maverstr/Thermography/README.md

# Thermography

Note : TFT_eSPI library should be moved into "Arduino/libraries" folder in root
