maverstr/Thermography/BillOfMatThermography.xlsx

Material | RS reference | URL | Price per component (£, ex. VAT) | Number of components
ESP32 | Digikey: ESP32-DEVKITC-32U-ND | https://www.digikey.co.uk/product-detail/en/espressif-systems/ESP32-DEVKITC-32U/ESP32-DEVKITC-32U-ND/9357002 | 8.23 | 1
MLX90640 | Digikey: MLX90640ESF-BAB-000-SP-ND | https://www.digikey.com/product-detail/en/melexis-technologies-nv/MLX90640ESF-BAB-000-SP/MLX90640ESF-BAB-000-SP-ND/8638466 | 37.27 | 1
ILI9341 TFT display | Digikey: 1528-1469-ND | https://www.digikey.com/products/en?mpart=1770&v=1528 | 24.09 | 1
Enclosure, ABS, 74x50x28mm | 314-5229 | https://uk.rs-online.com/web/p/potting-boxes/3145229/ | 1.592 | 1
BNC Connectors | 546-3995 | https://uk.rs-online.com/web/p/bnc-connectors/5463995/ | 2.49 | 1
Push-buttons SPST |  |  | 0.2 | 3
Toggle switches SPST | 419-855 | https://uk.rs-online.com/web/p/toggle-switches/0419855/ | 1.12 | 1
USB-C panel mount cable | Adafruit: 3258 | https://www.amazon.co.uk/Adafruit-Panel-Mount-Extension-Cable/dp/B0718XQPGB | 3.49 | 1
4-pin M12 automation cable | 724-2630 | https://uk.rs-online.com/web/p/sensor-switch-cables-connectors/7242630/ | 6.24 | 1
4-pin M12 straight connector | 124-7077 | https://uk.rs-online.com/web/p/industrial-automation-cable-assemblies/1247077/ | 4.38 | 1
Pin headers | 251-8351 | https://uk.rs-online.com/web/p/pcb-headers/2518351/ | 0.725 | 1
Total: |  |  | 90.227
PCB Ordering from JLCPCB |  |  | 1.61 | 1
PCB shipping to Leeds,UK | DHL internation shipping |  | 13 | 1
Some wires and Dupont wires
Electronics components
Resistors (ohms): | Number
16k | 1
160 | 1
10 | 1
Capacitors: (Farad)
10p | 1
10µ | 1
1µ | 1
100n | 1
Total including PCB and shipping: |  |  | 104.837
NOTE: Prices are mainly listed from RS components, VAT excluded. Prices taken 24/09/2019.
