maverstr/Thermography/Thermography_EAGLE_FILES_COPY/CAMOutputs/Assembly/wiring_thermography.txt

Partlist exported from C:/Users/Laurent/Documents/EAGLE/projects/ESP32 TEST/wiring_thermography.sch at 7/29/2019 9:21 AM

Qty Value         Device        Package        Parts                                                    Description               SPICEPREFIX
2                 C5/5          C5B5           C(RCANALOGOUT), C(RCSWITCH)                              CAPACITOR                            
1                 PINHD-1X1     1X01           ANALOGRCOUTPIN                                           PIN HEADER                           
1                 PINHD-1X10    1X10           LCDSPI                                                   PIN HEADER                           
1                 PINHD-1X5     1X05           MLX90640                                                 PIN HEADER                           
3                 R-EU_0207/7   0207/7         R(ANALOGOUT), R1(RCSWITCH), R2(RCSWITCH)                 RESISTOR, European symbol R          
1   100n          C5/5          C5B5           C2SUPPLYDECOUPLER                                        CAPACITOR                            
1   1µ            C5/5          C5B5           C1SUPPLYDECOUPLER                                        CAPACITOR                            
4   332-02        332-02        332-02         DRAWINGMODEPIN, REFFRAMEACTPIN, REFTAKEPIN, ROLLINGAVPIN 2 Pin - 2mm Dual Row                 
1   5v            PINHD-1X1     1X01           5VPIN                                                    PIN HEADER                           
1   ESP32DEVKITV1 ESP32DEVKITV1 ESP32-DEVKITV1 ESP32                                                                                         
3   gnd           PINHD-1X1     1X01           GNDPIN, GNDPIN2, GNDPIN3                                 PIN HEADER
