maverstr/Thermography/Thermography_EAGLE_FILES_COPY/wiring_thermography.brd

## EAGLE design Thermography_EAGLE_FILES_COPY/wiring_thermography.brd (2019-09-25)

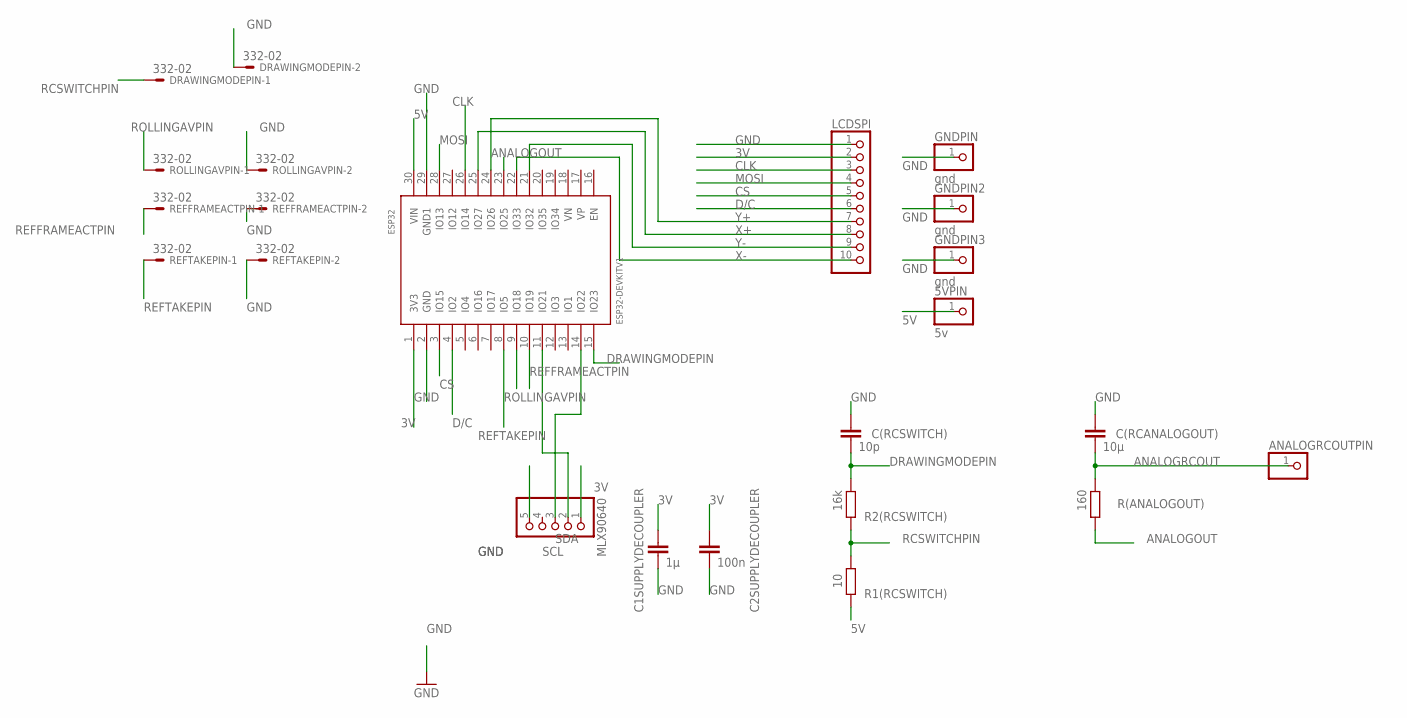
[picture p21: schematic wiring_thermography.sch]

Parts:
5VPIN: 5v; 1X01
ANALOGRCOUTPIN: PINHD-1X1; 1X01
C1SUPPLYDECOUPLER: 1µ; C5B5
C2SUPPLYDECOUPLER: 100n; C5B5
C(RCANALOGOUT): 10µ; C5B5
C(RCSWITCH): 10p; C5B5
DRAWINGMODEPIN: 332-02
ESP32: ESP32DEVKITV1; ESP32-DEVKITV1
GNDPIN, GNDPIN2, GNDPIN3: gnd; 1X01
LCDSPI: PINHD-1X10; 1X10
MLX90640: PINHD-1X5; 1X05
R1(RCSWITCH): 10; 0207/7
R2(RCSWITCH): 16k; 0207/7
R(ANALOGOUT): 160; 0207/7
REFFRAMEACTPIN: 332-02
REFTAKEPIN: 332-02
ROLLINGAVPIN: 332-02

Connections:
3V: C1SUPPLYDECOUPLER.1, C2SUPPLYDECOUPLER.1, ESP32.1 (3V3), LCDSPI.2, MLX90640.1
5V: 5VPIN.1, ESP32.30 (VIN), R1(RCSWITCH).1
ANALOGOUT: ESP32.23 (IO25), R(ANALOGOUT).1
ANALOGRCOUT: ANALOGRCOUTPIN.1, C(RCANALOGOUT).2, R(ANALOGOUT).2
CLK: ESP32.26 (IO14), LCDSPI.3
CS: ESP32.3 (IO15), LCDSPI.5
D/C: ESP32.4 (IO2), LCDSPI.6
DRAWINGMODEPIN: C(RCSWITCH).2, ESP32.15 (IO23), R2(RCSWITCH).2
GND: C1SUPPLYDECOUPLER.2, C2SUPPLYDECOUPLER.2, C(RCANALOGOUT).1, C(RCSWITCH).1, DRAWINGMODEPIN.2, ESP32.2 (GND), ESP32.29 (GND1), GNDPIN.1, GNDPIN2.1, GNDPIN3.1, LCDSPI.1, MLX90640.5, REFFRAMEACTPIN.2, REFTAKEPIN.2, ROLLINGAVPIN.2
MOSI: ESP32.28 (IO13), LCDSPI.4
RCSWITCHPIN: DRAWINGMODEPIN.1, R1(RCSWITCH).2, R2(RCSWITCH).1
REFFRAMEACTPIN: ESP32.10 (IO19), REFFRAMEACTPIN.1
REFTAKEPIN: ESP32.8 (IO5), REFTAKEPIN.1
ROLLINGAVPIN: ESP32.9 (IO18), ROLLINGAVPIN.1
SCL: ESP32.14 (IO22), MLX90640.3
SDA: ESP32.11 (IO21), MLX90640.2
X+: ESP32.25 (IO27), LCDSPI.8
X-: ESP32.22 (IO33), LCDSPI.10
Y+: ESP32.24 (IO26), LCDSPI.7
Y-: ESP32.21 (IO32), LCDSPI.9

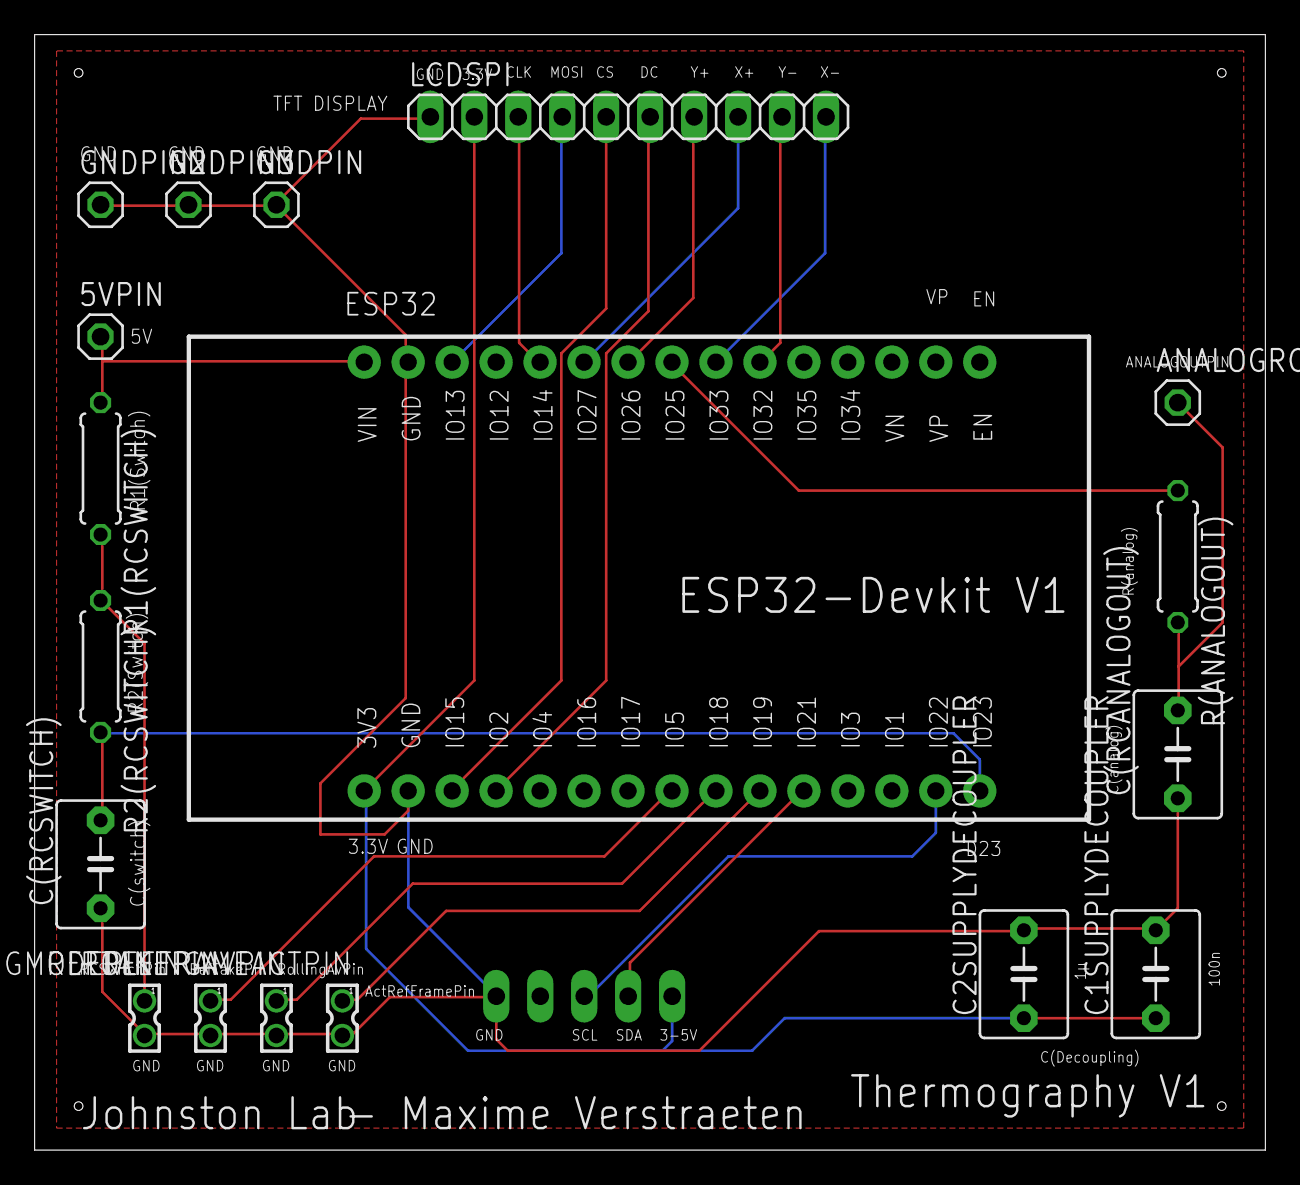
[picture p22: board wiring_thermography.brd from above]

Board: 2 copper layers, 71.1 x 64.4 mm, 19 parts (1 on the bottom side), 20 nets.
