maverstr/Thermography/(commit log)

2019-08-06 added Processing and graphic test
    [7-19--10-19-3.csv, 7-19--10-6-9.csv, 7-19--10-7-43.csv, 7-19--17-11-22.csv, 7-19--17-15-7.csv, 7-19--17-16-50.csv, 7-19--17-17-40.csv, 7-19--17-20-29.csv]
2019-08-06 updating reference frame with regards to calibration data
2019-08-07 automatic calibration rm + reference frame over 16 frames
2019-08-07 corrected calibration
2019-08-07 corrected calibration scaling
2019-08-15 updates vdd and ta on calibration
2019-08-16 calibration improved + std bug fixed
    [Thermography_ESP32.ino]
2019-08-22 corrected waiting for new data
    [MLX90640_I2C_Driver.cpp, Thermography_ESP32.ino]
2019-08-23 fixed calibration
2019-08-23 rolling 2 frames + more precise framerate
2019-09-06 added python script visualisation
    [7-31--15-24-47.csv]
2019-09-09 added library
    [Configuring options.txt]
2019-09-16 added eagle files
    [copper_bottom.gbr, copper_top.gbr, drill_1_16.xln, gerber_job.gbrjob, profile.gbr, silkscreen_bottom.gbr, silkscreen_top.gbr, soldermask_bottom.gbr]
2019-09-17 added eeprom storage of values + reference frame taken on full frame whatever the cropping
2019-09-18 updated python viz to adapt to multiple crops
    [7-19--10-19-3.csv, 7-19--10-6-9.csv, 7-19--10-7-43.csv, 7-19--17-11-22.csv, 7-19--17-15-7.csv, 7-19--17-16-50.csv, 7-19--17-17-40.csv, 7-19--17-20-29.csv]
2019-09-25 added bill of mats
    [BillOfMatThermography.xlsx]
2019-09-25 updated eagle files
    [BillOfMatThermography.xlsx, wiring_thermography.brd, wiring_thermography.sch]
